csraxll/taller1-g8/README.md

# taller1-g8
Repositorio del proyecto del Grupo 8 para la materia Taller de Proyecto 1 - Ingeniería en Computación - UNLP
