csraxll/taller1-g8/Informe_Final_Presentación.pdf

# Taller de Proyecto I -Informe Final

Proyecto: Controlador de cartel LED Grupo: 8
Integrantes:
Jourdón, Julián (424/7)
Maicá, Juan Manuel (436/2) López Acuña, Axel (248/9)
Scorza, Facundo Ricardo (615/3)

# Presentación

- Objetivos del proyecto y esquema inicial.
- Requerimientos funcionales y no funcionales del sistema.
- Presupuesto.
- Puertos de la CIAA utilizados.
- Diseño del poncho y del cartel LED.
- Interfaz de usuario y máquina de estados.
- Tareas y módulos de software.
- Distribución del proyecto.
- Sistema final en funcionamiento.

# Objetivos del proyecto

- Nuestro proyecto consiste en desarrollar un controlador para un cartel LED que podría estar conformado por una o varias matrices de LEDs acopladas e interconectadas entre sí.
- El controlador contará con una lógica tal que podrá mostrar en el cartel cualquier tipo de mensaje y lo desplazará a través de las matrices.

# Esquema inicial

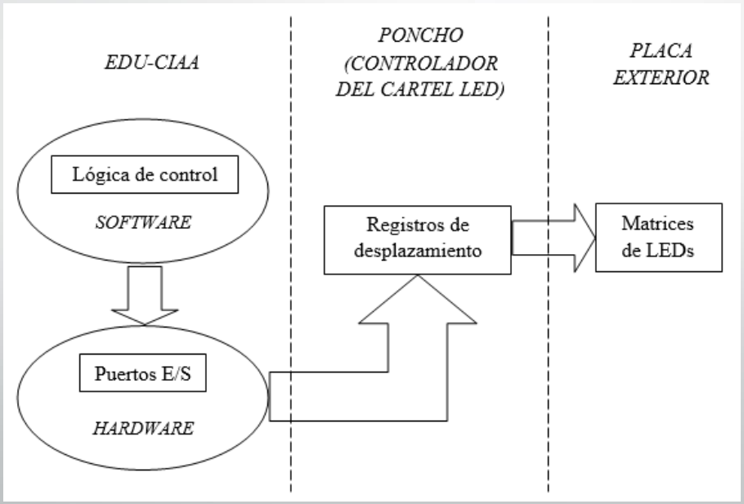
[picture p2: figure]

# Requerimientos funcionales del sistema

- Funciones principales del sistema:
- Ingresar mensaje.
- Realizar una operación aritmética.
- Llevar a cabo una conversión entre sistemas de numeración.
- Interacción del usuario con el cartel LED.

# Requerimientos no funcionales del sistema

- Interacción del usuario con el sistema.
- Dimensiones del cartel LED.
- Diseño del poncho.
- Dimensiones de las matrices de LEDs.
- Sistema operativo y lenguaje de programación.

# Presupuesto

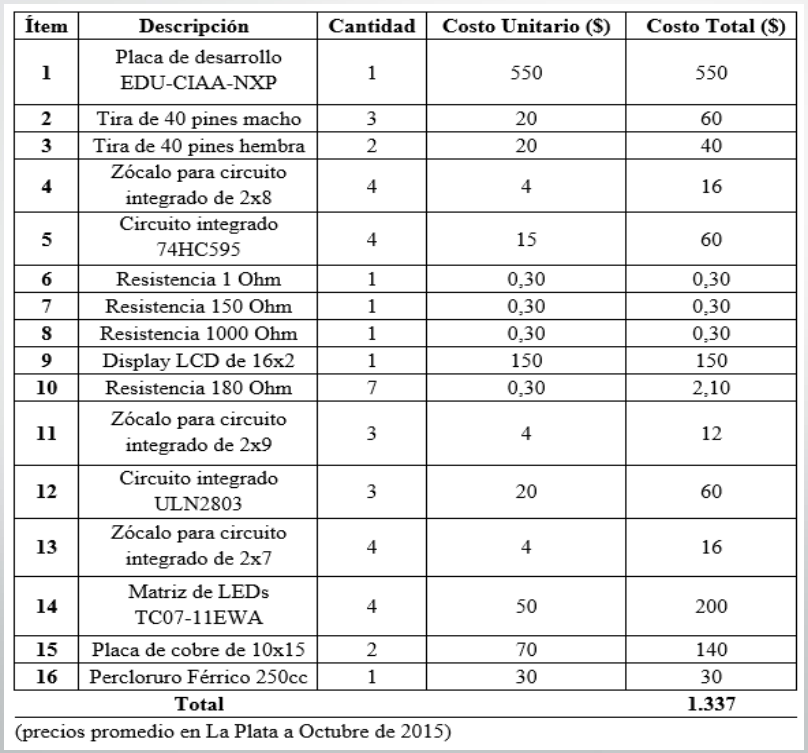
[picture p3: figure]

# Puertos de la CIAA utilizados

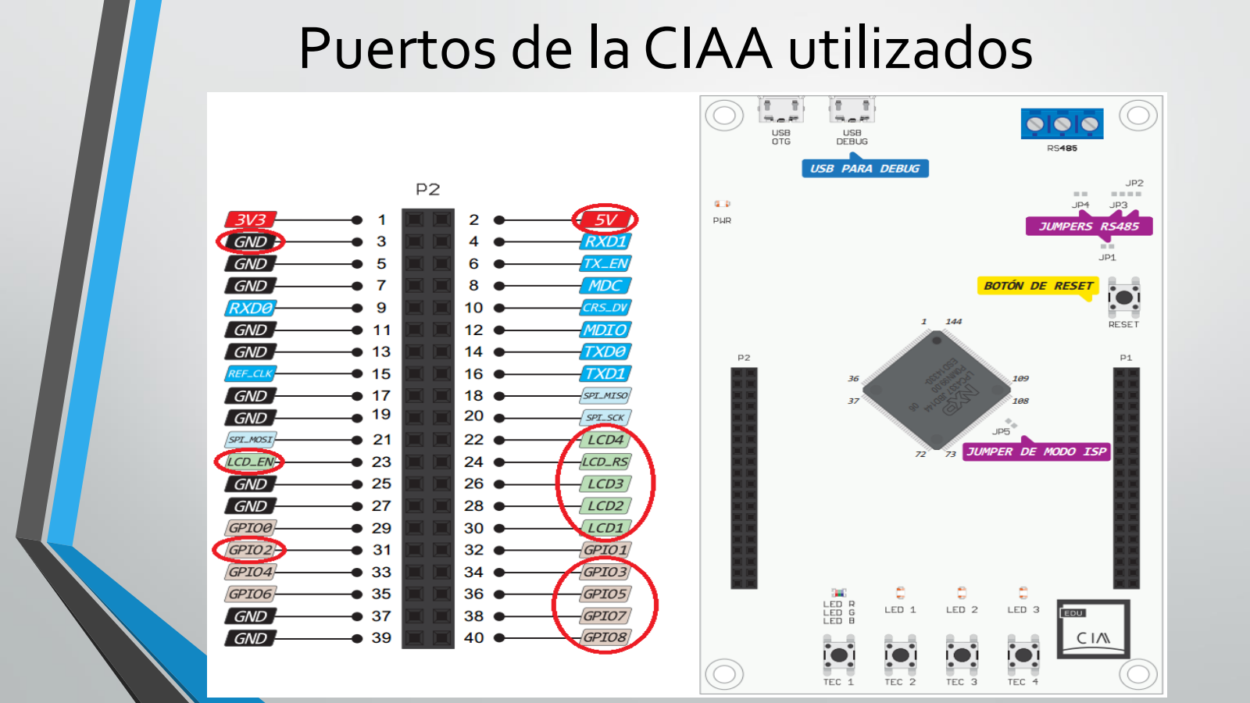
[picture p4: page 8]

# Diseño del poncho

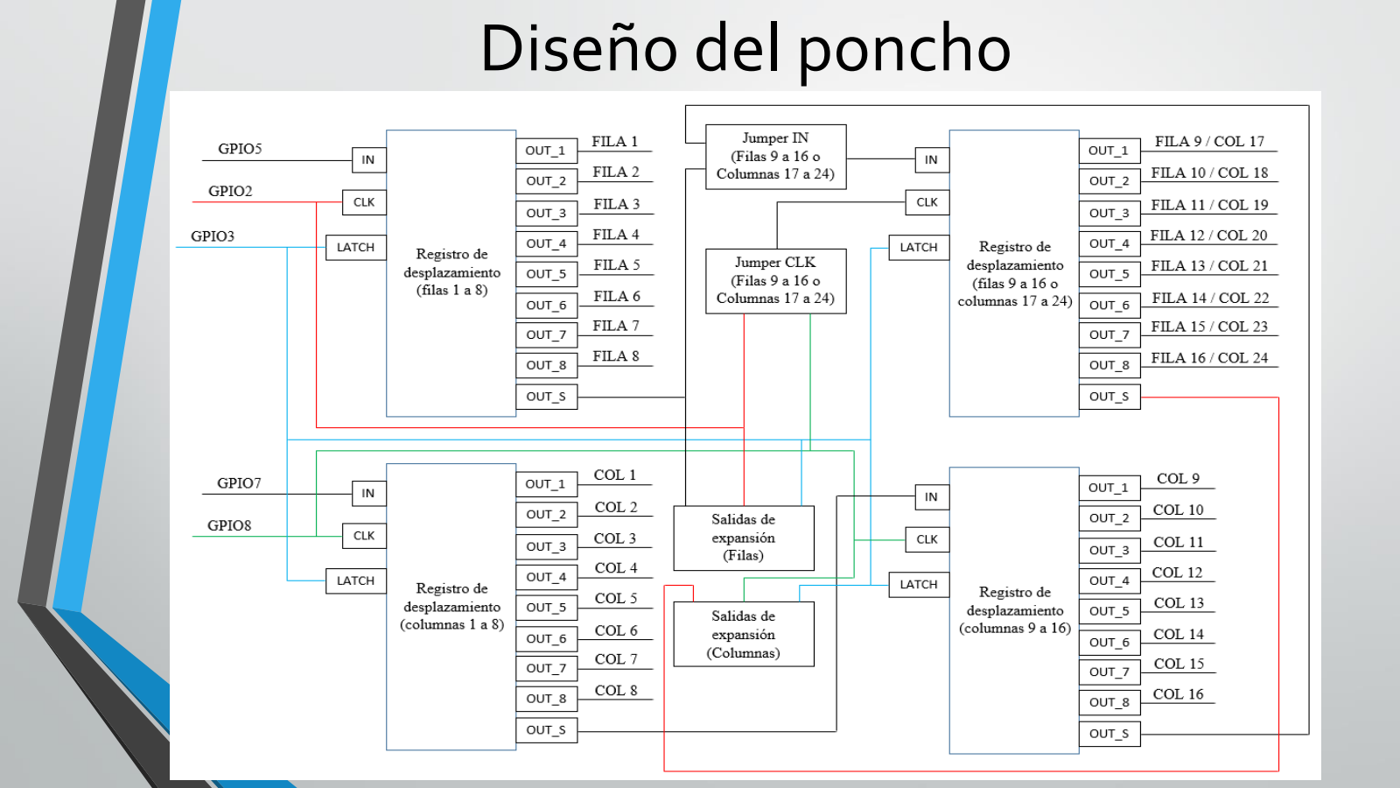
[picture p5: page 9]

# Diseño del poncho

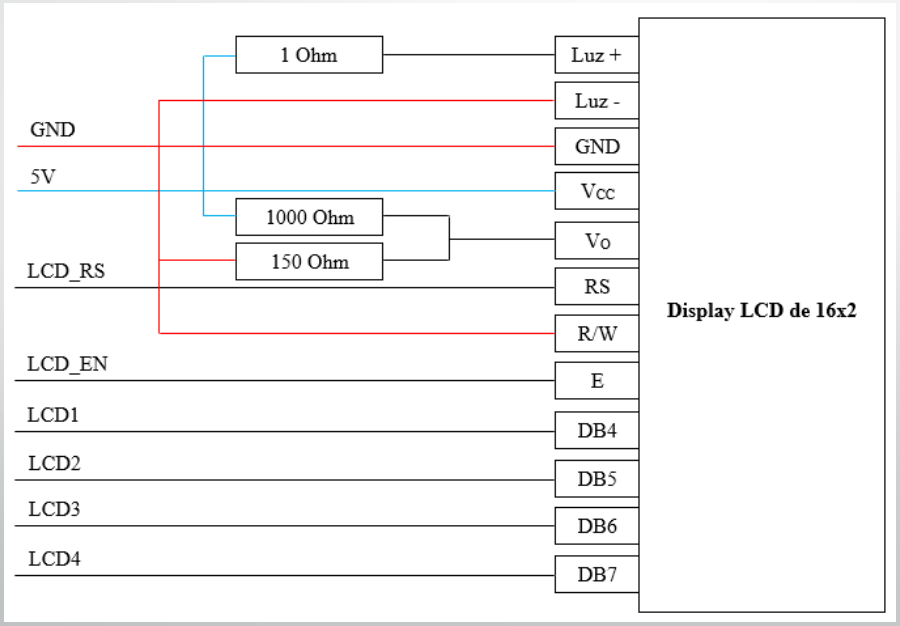
[picture p6: figure]

# Diseño del cartel LED

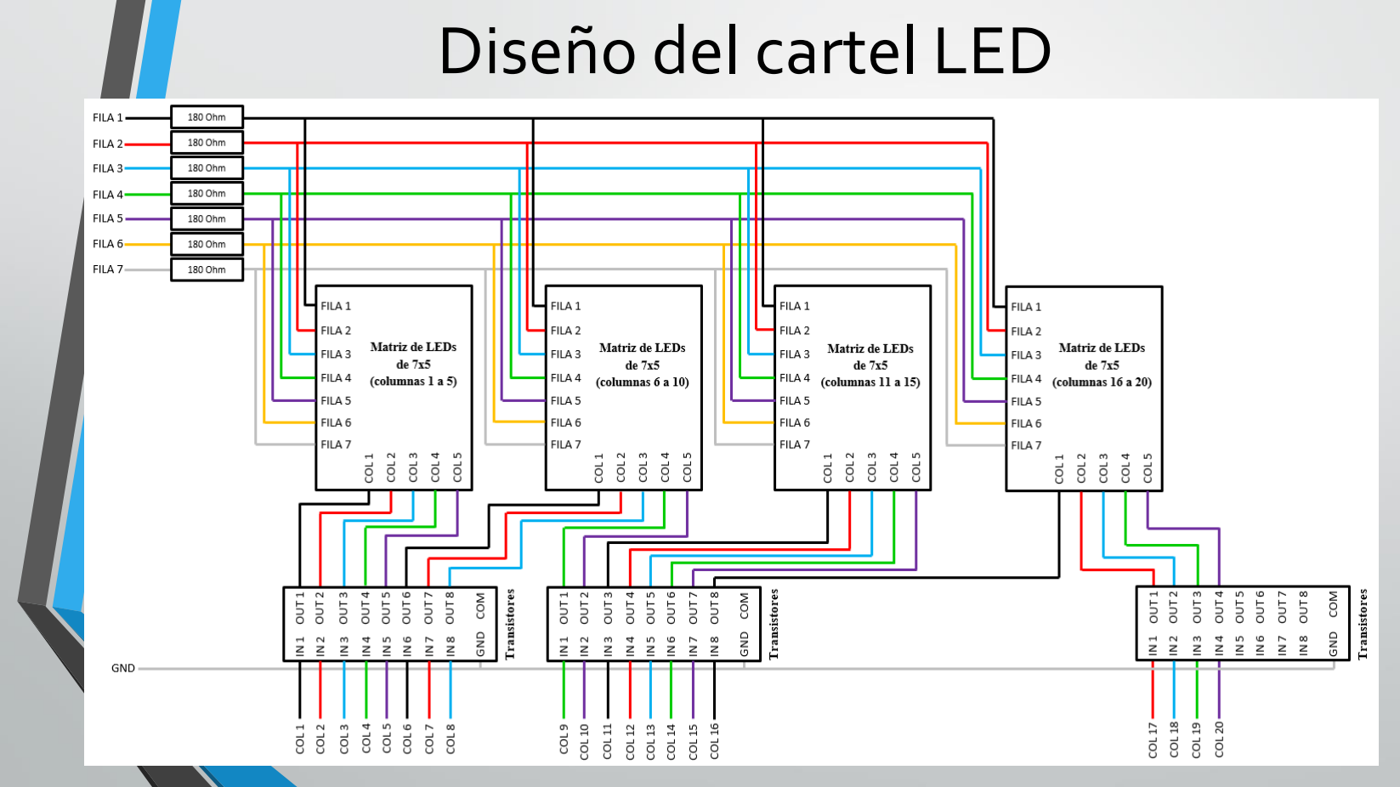
[picture p7: page 11]

# Interfaz de usuario

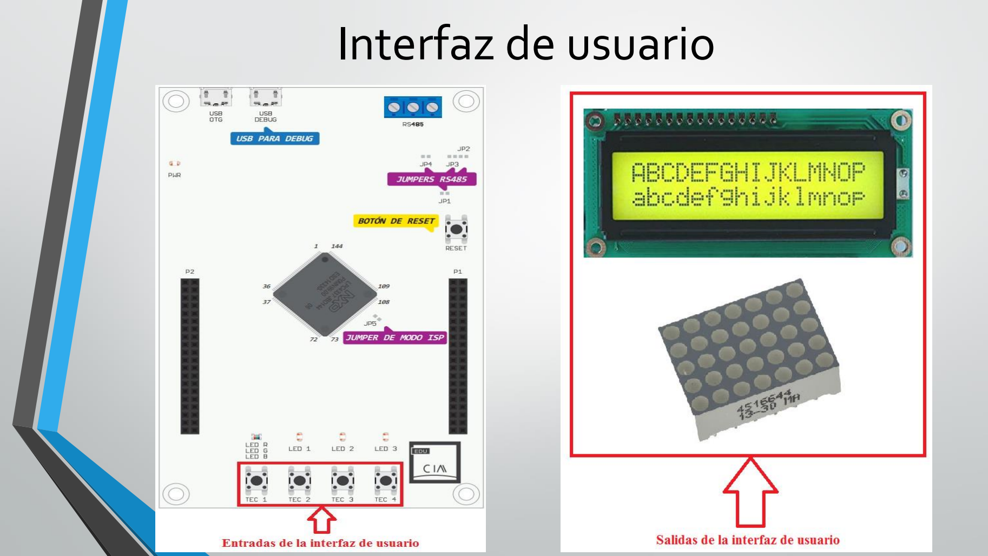
[picture p8: page 12]

# Máquina de estados

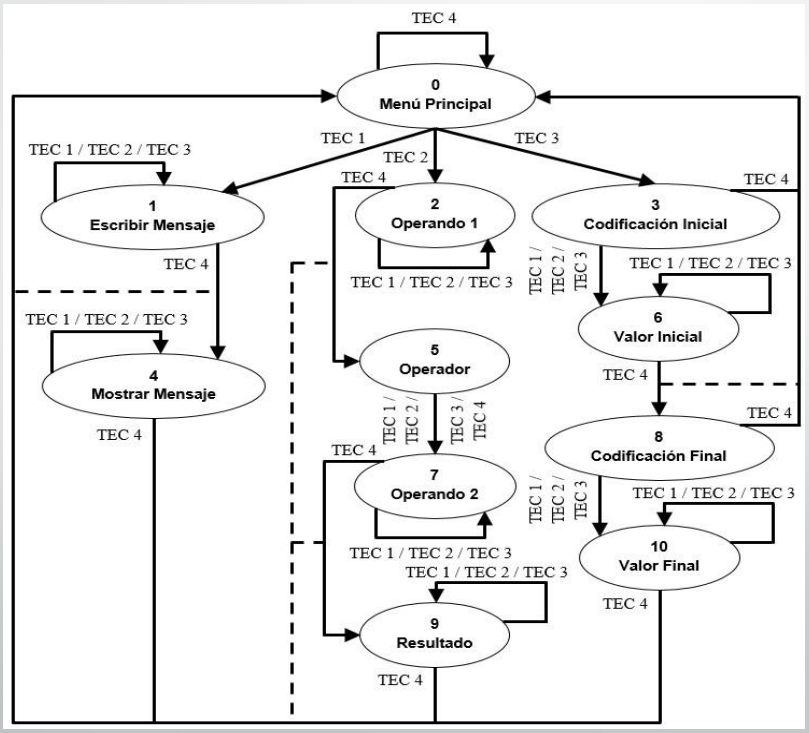
[picture p9: figure]

# Tareas

- InitTask → Se ejecuta una única vez al principio
- LcdTask → Período = 10 milisegundos
- MatrizTask → Período = 25 milisegundos
- RegistrosTask → Período = 1 milisegundo
- SwitchesTask → Período = 10 milisegundos

# Módulos de software

- Calculadora.
- Conversor.
- Interfaz.
- Lcd.
- Matriz.

# Módulos de software

- Proyecto.
- Puertos.
- Registros.
- Switches.
- Tiempo.

# Distribución del proyecto

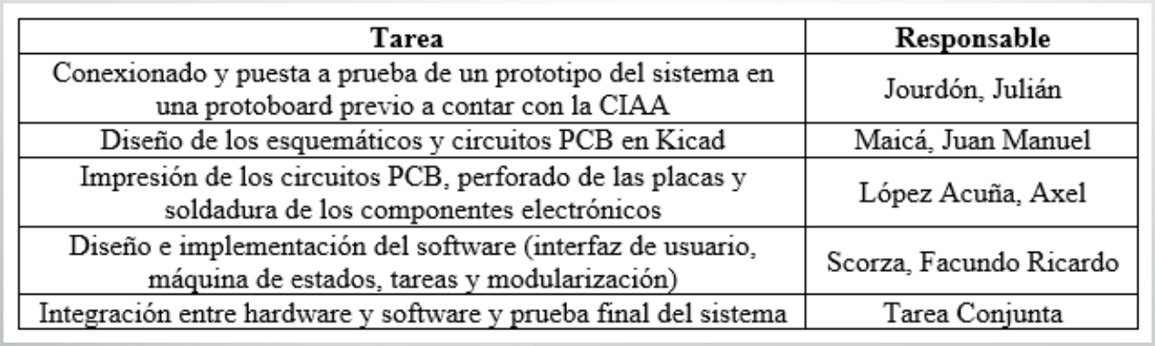
[picture p10: figure]

# Sistema final en funcionamiento

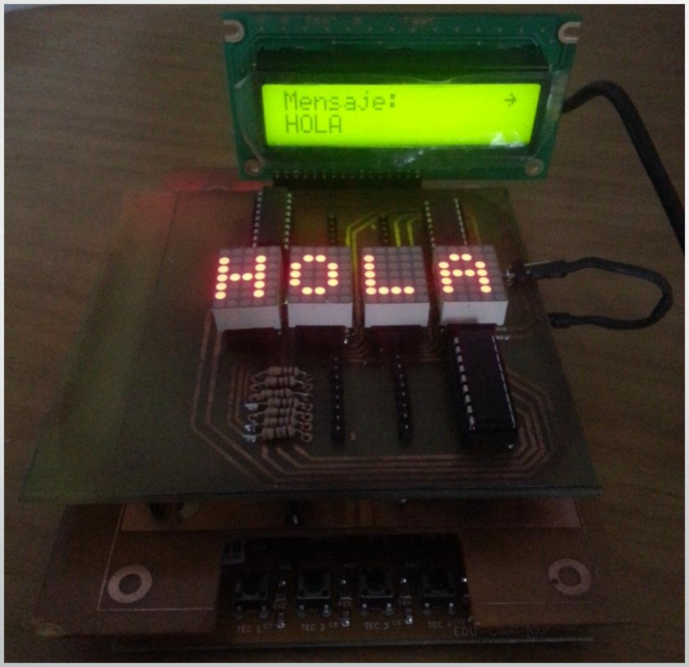
[picture p11: figure]

# ¿Preguntas?

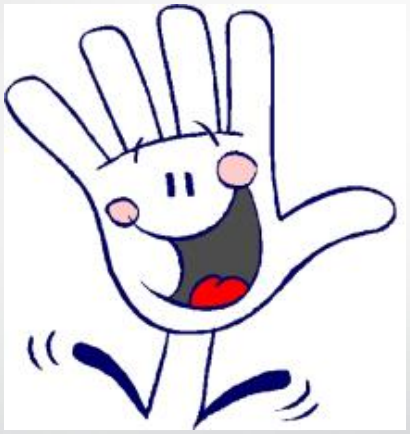
[picture p12: figure]

# ¡Muchas gracias!

Proyecto Github: www.github.com/csraxll/taller1-g8
