csraxll/taller1-g8/Hardware/PCB/MatrizLED/doc/CAMBIOS.txt

Historial de cambios realizados 
================================

* Fecha: 22/02/2016
* Autores: Juan Manuel Maicá, Lopez Acuña Axel
* Archivos:   - MatrizLED.sch
              - MatrizLED.kicad_pcb
              - MatrizLED.net
              - MatrizLED.pro
              - MatrizLED-cache.lib
* Descripción: Se parte de los Modelos de Ponchos en: 
               http://www.proyecto-ciaa.com.ar/devwiki/doku.php?id=desarrollo:edu-ciaa:ponchos_modelos
               <<Colocar aquí información de cambios importantes y de gran volumen, releases, contribuciones
                de terceros, etc.>>
