csraxll/taller1-g8/Hardware/PCB/MatrizLED/doc/Impreso - Dos Caras.pdf

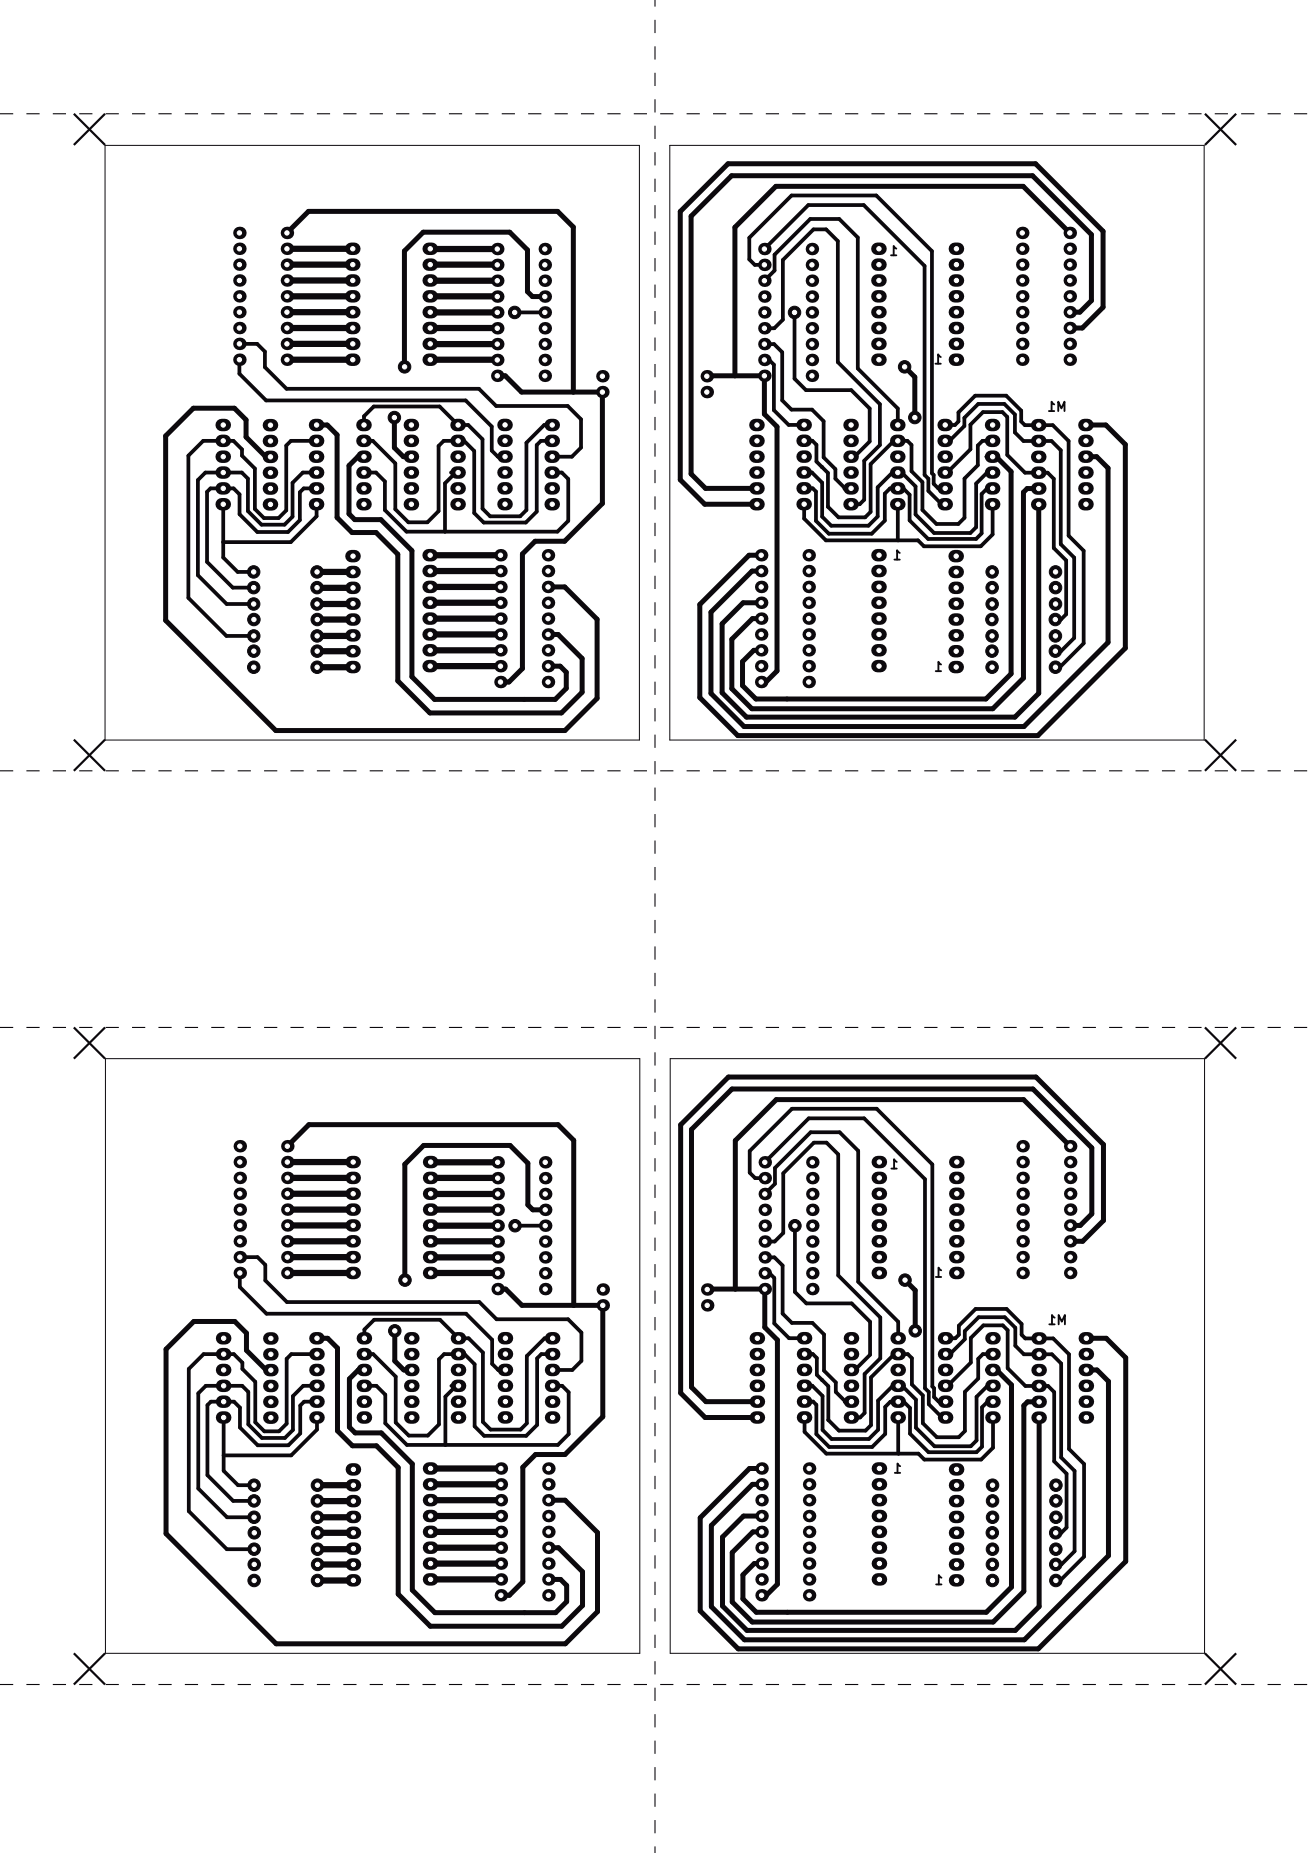
[picture p44: page 1]
