csraxll/taller1-g8/Hardware/PCB/ControladorMatrizLED/doc/Impreso - Back.pdf

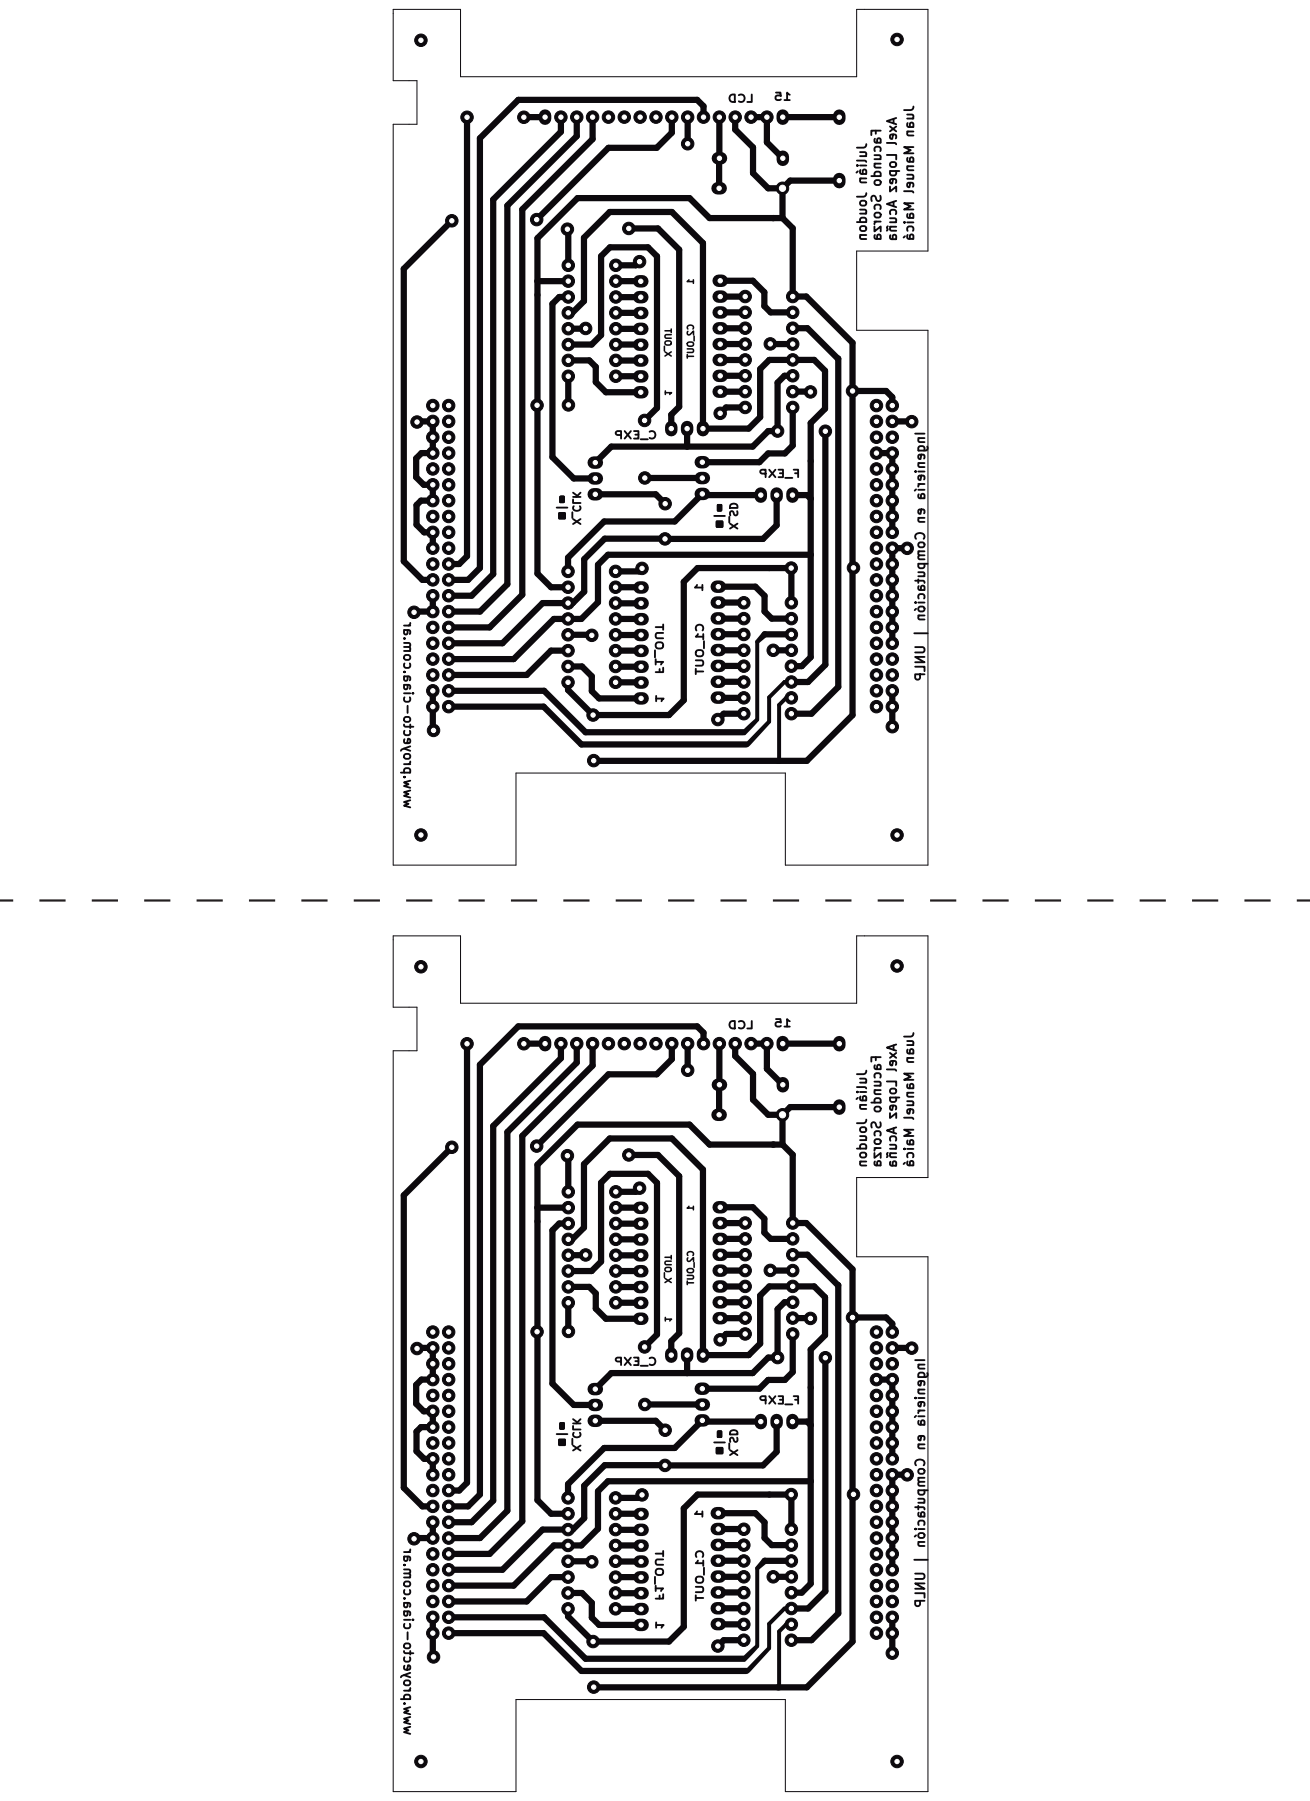
[picture p45: page 1]
