csraxll/taller1-g8/Hardware/PCB/MatrizLED/MatrizLED.kicad_pcb

## KiCad design Hardware/PCB/MatrizLED/MatrizLED.kicad_pcb (2016-01-29)

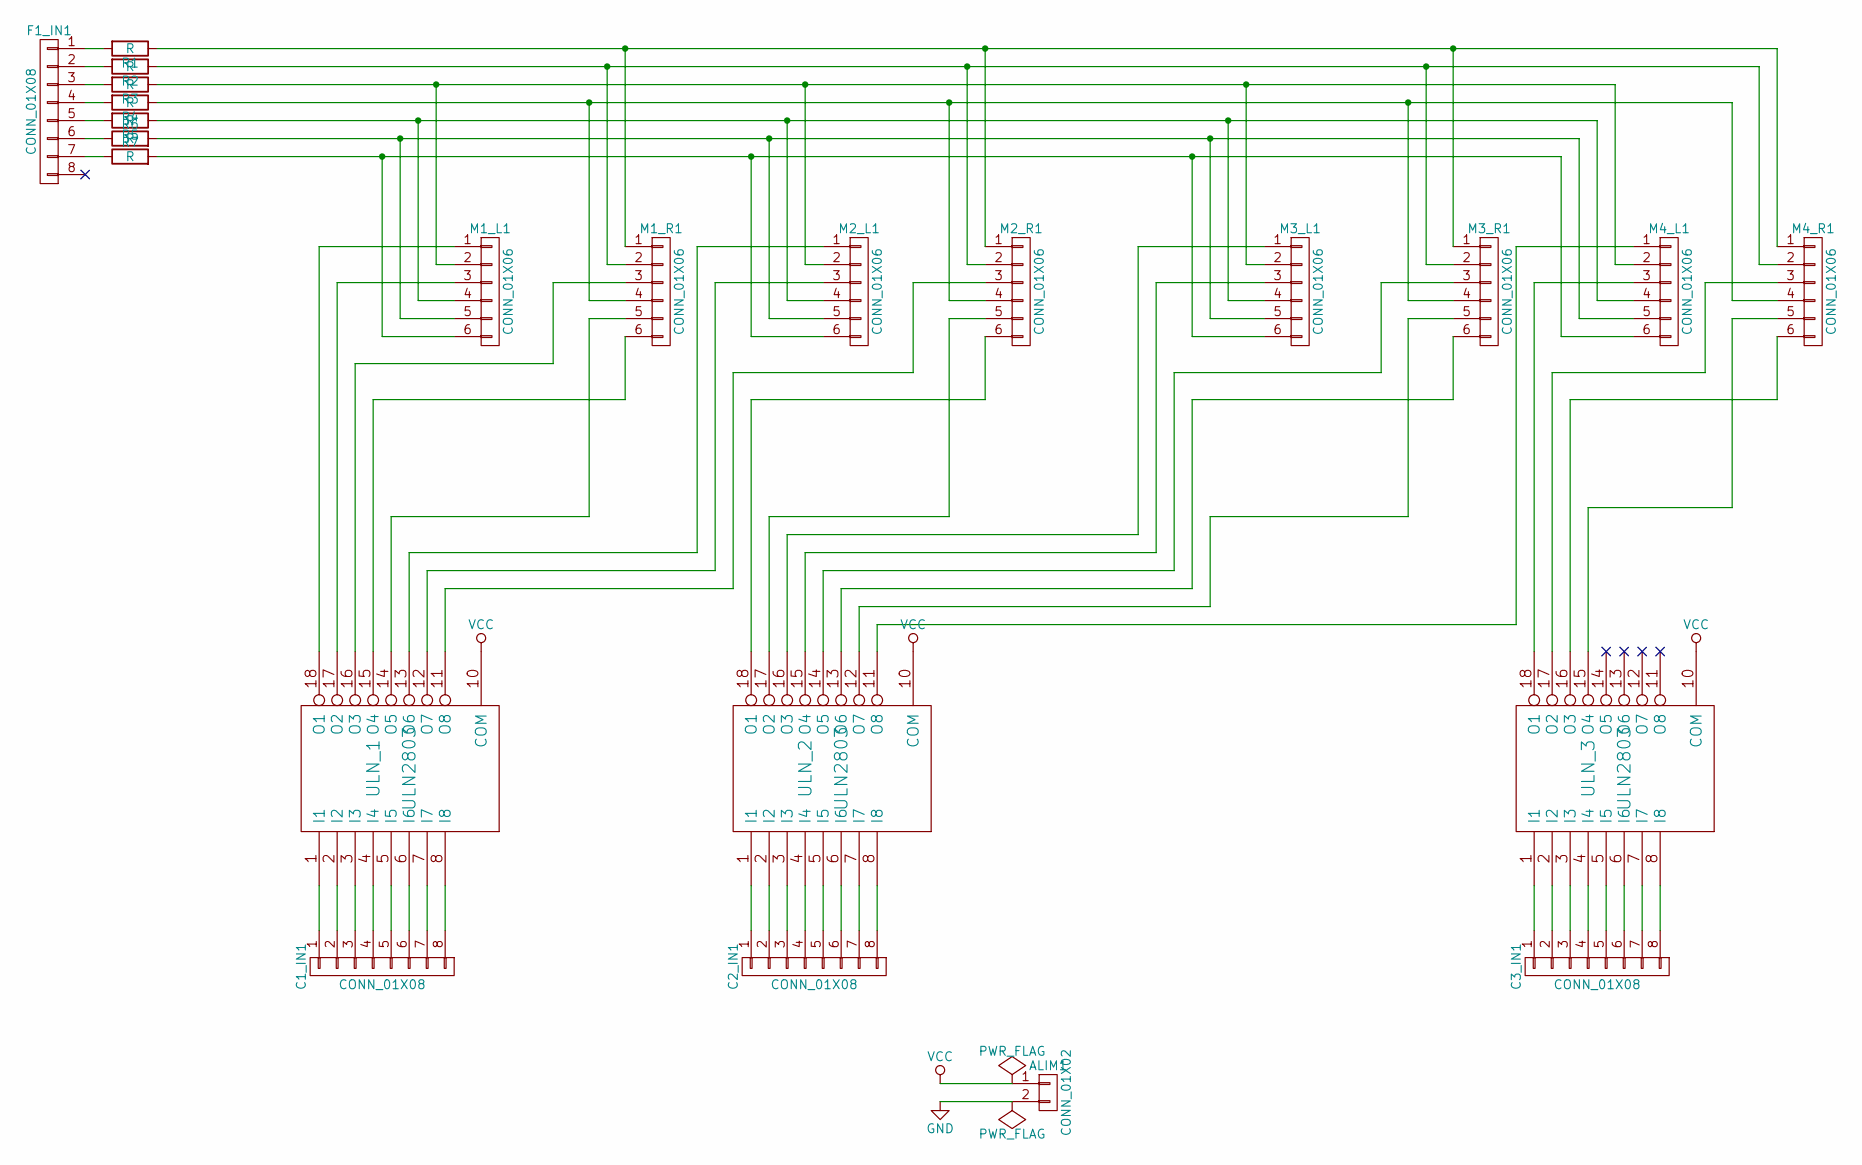
[picture p46: schematic MatrizLED.sch]

Parts:
ALIM1: CONN_01X02; Pin_Header_Straight_1x02
C1_IN1, C2_IN1, C3_IN1: CONN_01X08; Pin_Header_Straight_1x08
F1_IN1: CONN_01X08; Pin_Header_Straight_1x08
M1_L1, M1_R1, M2_L1, M2_R1, M3_L1, M3_R1, M4_L1, M4_R1: CONN_01X06; Pin_Header_Straight_1x06
R1, R2, R3, R4, R5, R6, R7: R; Resistor_Horizontal_RM10mm
ULN_1, ULN_2, ULN_3: ULN2803; DIP-18_W7.62mm

Connections:
GND: ALIM1.2, ULN_1.9 (GND), ULN_2.9 (GND), ULN_3.9 (GND)
unnamed: C1_IN1.1, ULN_1.1 (I1)
unnamed: C1_IN1.2, ULN_1.2 (I2)
unnamed: C1_IN1.3, ULN_1.3 (I3)
unnamed: C1_IN1.4, ULN_1.4 (I4)
unnamed: C1_IN1.5, ULN_1.5 (I5)
unnamed: C1_IN1.6, ULN_1.6 (I6)
unnamed: C1_IN1.7, ULN_1.7 (I7)
unnamed: C1_IN1.8, ULN_1.8 (I8)
unnamed: C2_IN1.1, ULN_2.1 (I1)
unnamed: C2_IN1.2, ULN_2.2 (I2)
unnamed: C2_IN1.3, ULN_2.3 (I3)
unnamed: C2_IN1.4, ULN_2.4 (I4)
unnamed: C2_IN1.5, ULN_2.5 (I5)
unnamed: C2_IN1.6, ULN_2.6 (I6)
unnamed: C2_IN1.7, ULN_2.7 (I7)
unnamed: C2_IN1.8, ULN_2.8 (I8)
unnamed: C3_IN1.1, ULN_3.1 (I1)
unnamed: C3_IN1.2, ULN_3.2 (I2)
unnamed: C3_IN1.3, ULN_3.3 (I3)
unnamed: C3_IN1.4, ULN_3.4 (I4)
unnamed: C3_IN1.5, ULN_3.5 (I5)
unnamed: C3_IN1.6, ULN_3.6 (I6)
unnamed: C3_IN1.7, ULN_3.7 (I7)
unnamed: C3_IN1.8, ULN_3.8 (I8)
unnamed: F1_IN1.1, R1.2
unnamed: F1_IN1.2, R2.2
unnamed: F1_IN1.3, R3.2
unnamed: F1_IN1.4, R4.2
unnamed: F1_IN1.5, R5.2
unnamed: F1_IN1.6, R6.1
unnamed: F1_IN1.7, R7.1
unnamed: M1_L1.1, ULN_1.18 (O1)
unnamed: M1_L1.2, M2_L1.2, M3_L1.2, M4_L1.2, R3.1
unnamed: M1_L1.3, ULN_1.17 (O2)
unnamed: M1_L1.4, M2_L1.4, M3_L1.4, M4_L1.4, R5.1
unnamed: M1_L1.5, M2_L1.5, M3_L1.5, M4_L1.5, R6.2
unnamed: M1_L1.6, M2_L1.6, M3_L1.6, M4_L1.6, R7.2
unnamed: M1_R1.1, M2_R1.1, M3_R1.1, M4_R1.1, R1.1
unnamed: M1_R1.2, M2_R1.2, M3_R1.2, M4_R1.2, R2.1
unnamed: M1_R1.3, ULN_1.16 (O3)
unnamed: M1_R1.4, M2_R1.4, M3_R1.4, M4_R1.4, R4.1
unnamed: M1_R1.5, ULN_1.14 (O5)
unnamed: M1_R1.6, ULN_1.15 (O4)
unnamed: M2_L1.1, ULN_1.13 (O6)
unnamed: M2_L1.3, ULN_1.12 (O7)
unnamed: M2_R1.3, ULN_1.11 (O8)
unnamed: M2_R1.5, ULN_2.17 (O2)
unnamed: M2_R1.6, ULN_2.18 (O1)
unnamed: M3_L1.1, ULN_2.16 (O3)
unnamed: M3_L1.3, ULN_2.15 (O4)
unnamed: M3_R1.3, ULN_2.14 (O5)
unnamed: M3_R1.5, ULN_2.12 (O7)
unnamed: M3_R1.6, ULN_2.13 (O6)
unnamed: M4_L1.1, ULN_2.11 (O8)
unnamed: M4_L1.3, ULN_3.18 (O1)
unnamed: M4_R1.3, ULN_3.17 (O2)
unnamed: M4_R1.5, ULN_3.15 (O4)
unnamed: M4_R1.6, ULN_3.16 (O3)
VCC: ALIM1.1, ULN_1.10 (COM), ULN_2.10 (COM), ULN_3.10 (COM)

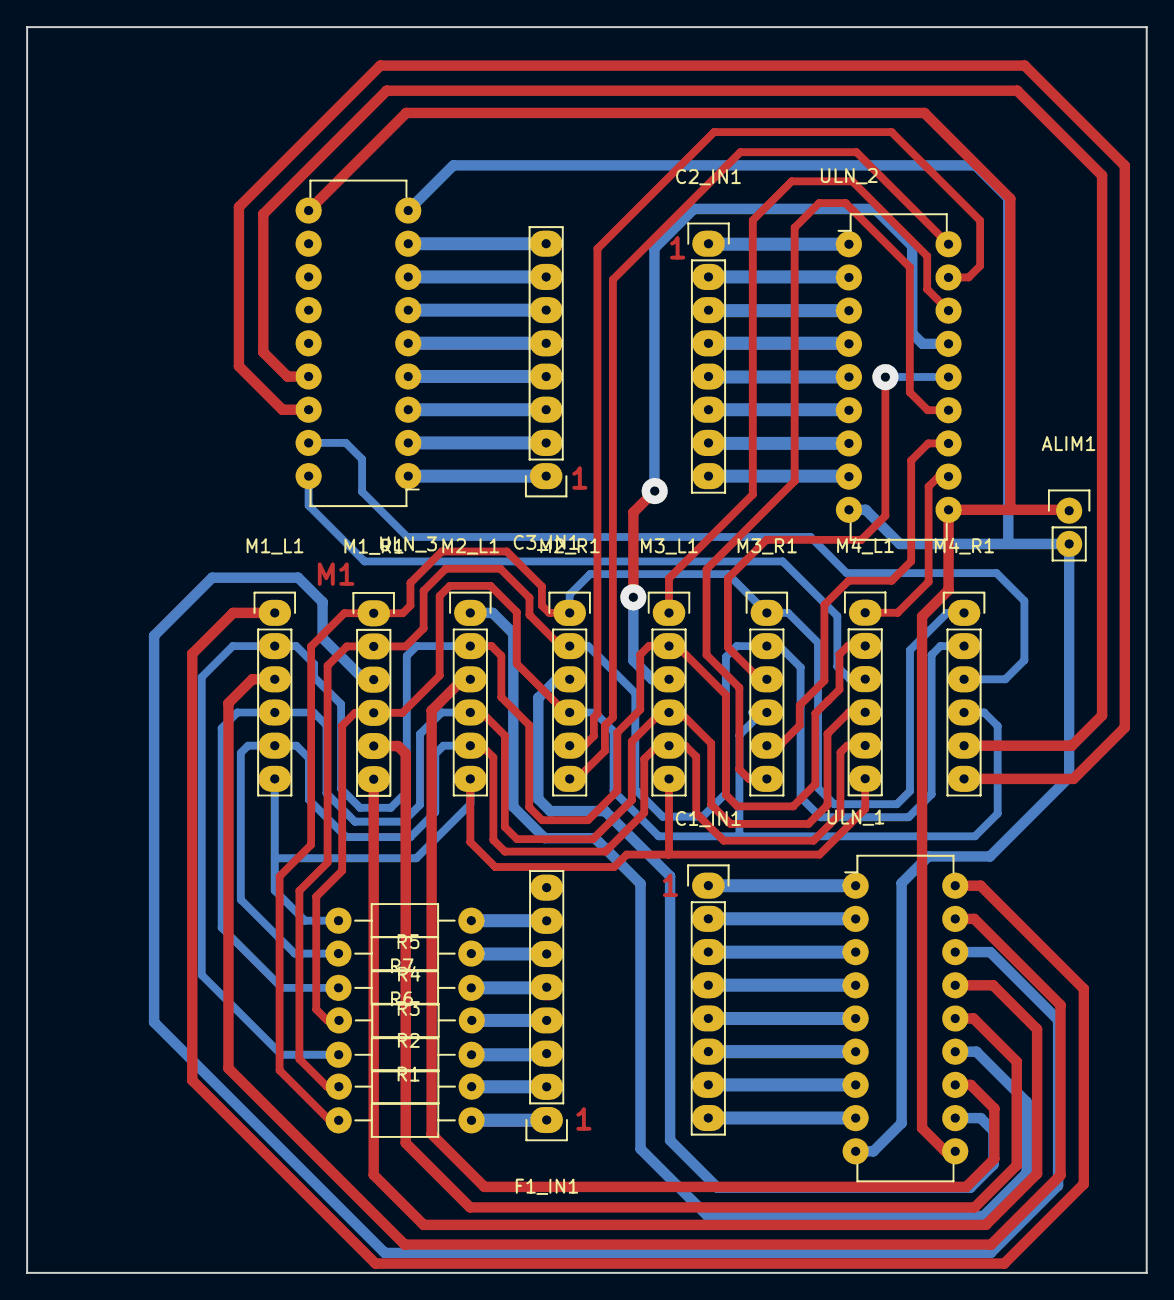
[picture p47: board MatrizLED.kicad_pcb from above]

Board: 2 copper layers, 85.7 x 95.3 mm, 23 parts (0 on the bottom side), 60 nets.
