csraxll/taller1-g8/Hardware/PCB/ControladorMatrizLED/ControladorMatrizLED.kicad_pcb

## KiCad design Hardware/PCB/ControladorMatrizLED/ControladorMatrizLED.kicad_pcb (2015-12-13)

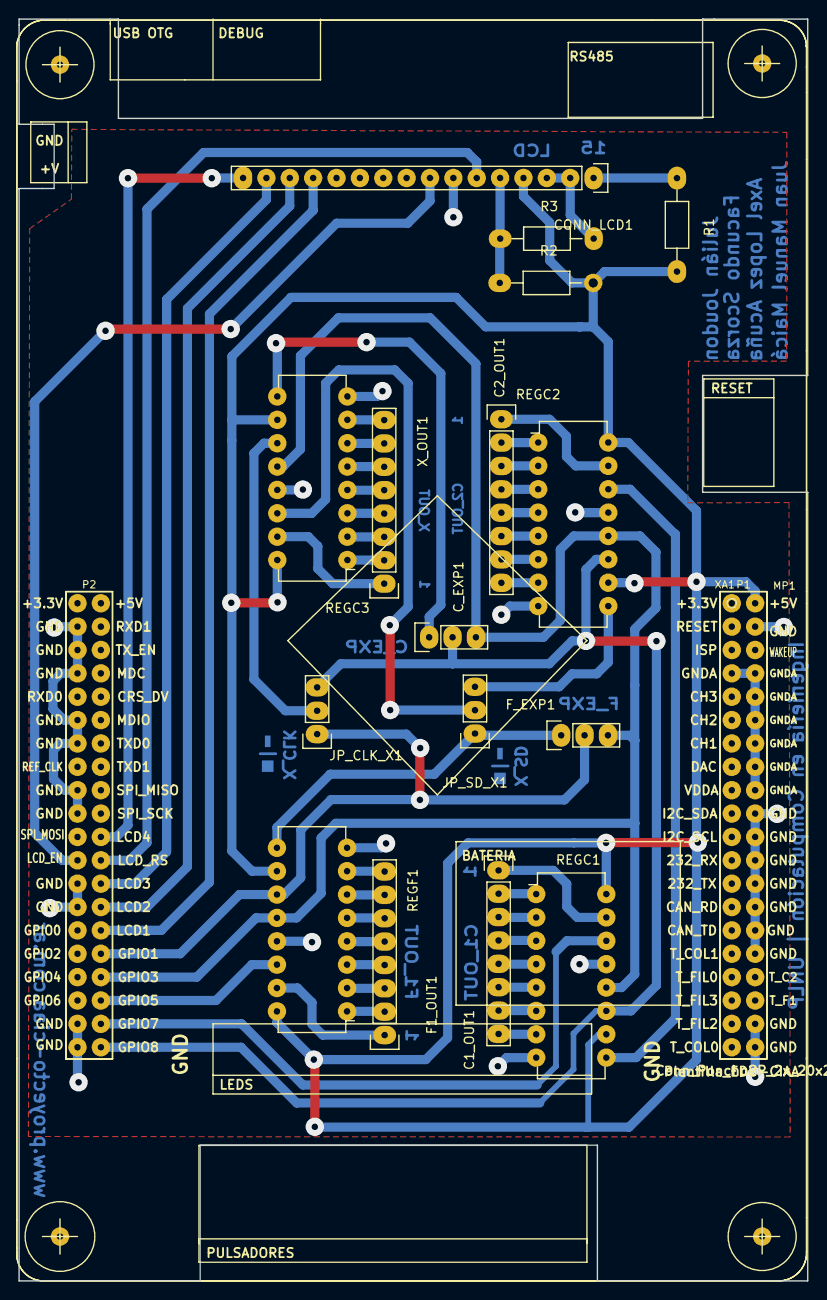
[picture p48: board ControladorMatrizLED.kicad_pcb from above]

Board: 2 copper layers, 85.7 x 137.2 mm, 18 parts (0 on the bottom side), 54 nets.

Parts:
C1_OUT1, C2_OUT1: CONN_01X08; Socket_Strip_Straight_1x08
CONN_LCD1: CONN_01X16; Socket_Strip_Straight_1x16
C_EXP1: CONN_01X03; Socket_Strip_Straight_1x03
F1_OUT1: CONN_01X08; Socket_Strip_Straight_1x08
F_EXP1: CONN_01X03; Socket_Strip_Straight_1x03
JP_CLK_X1: CONN_01X03; Socket_Strip_Straight_1x03
JP_SD_X1: CONN_01X03; Socket_Strip_Straight_1x03
MP1: Plantilla_EDU-CIAA
R1, R2, R3: R; Resistor_Horizontal_RM10mm
REGC1, REGC2, REGC3: 74HC595; DIP-16_W7.62mm
REGF1: 74HC595; DIP-16_W7.62mm
XA1: Conn_Poncho2P_2x_20x2; poncho_grande
X_OUT1: CONN_01X08; Socket_Strip_Straight_1x08

Connections:
/Circuito Principal/GPIO1: F_EXP1.2, JP_CLK_X1.1, REGF1.11, XA1.72
/Circuito Principal/GPIO3: C_EXP1.3, F_EXP1.3, REGC1.12, REGC2.12, REGC3.12, REGF1.12, XA1.74
/Circuito Principal/GPIO5: REGF1.14, XA1.76
/Circuito Principal/GPIO7: REGC1.14, XA1.78
/Circuito Principal/GPIO8: C_EXP1.2, JP_CLK_X1.3, REGC1.11, REGC2.11, XA1.80
/Circuito Principal/LCD1: CONN_LCD1.13, XA1.70
/Circuito Principal/LCD2: CONN_LCD1.14, XA1.68
/Circuito Principal/LCD3: CONN_LCD1.15, XA1.66
/Circuito Principal/LCD4: CONN_LCD1.16, XA1.62
/Circuito Principal/LCD_EN: CONN_LCD1.8, XA1.63
/Circuito Principal/RS: CONN_LCD1.6, XA1.64
GND: CONN_LCD1.2, CONN_LCD1.3, CONN_LCD1.7, R3.2, REGC1.8, REGC1.13, REGC2.8, REGC2.13, REGC3.8, REGC3.13, REGF1.8, REGF1.13, XA1.4, XA1.20, XA1.22, XA1.24, XA1.26, XA1.28, XA1.30, XA1.32, XA1.38, XA1.40, XA1.43, XA1.45, XA1.47, XA1.51, XA1.53, XA1.57, XA1.59, XA1.65, XA1.67, XA1.77, XA1.79
GNDA: XA1.7, XA1.8, XA1.10, XA1.12, XA1.14, XA1.16, XA1.18
unnamed: C1_OUT1.1, REGC1.15
unnamed: C1_OUT1.2, REGC1.1
unnamed: C1_OUT1.3, REGC1.2
unnamed: C1_OUT1.4, REGC1.3
unnamed: C1_OUT1.5, REGC1.4
unnamed: C1_OUT1.6, REGC1.5
unnamed: C1_OUT1.7, REGC1.6
unnamed: C1_OUT1.8, REGC1.7
unnamed: C2_OUT1.1, REGC2.15
unnamed: C2_OUT1.2, REGC2.1
unnamed: C2_OUT1.3, REGC2.2
unnamed: C2_OUT1.4, REGC2.3
unnamed: C2_OUT1.5, REGC2.4
unnamed: C2_OUT1.6, REGC2.5
unnamed: C2_OUT1.7, REGC2.6
unnamed: C2_OUT1.8, REGC2.7
unnamed: CONN_LCD1.1, R1.1
unnamed: CONN_LCD1.5, R2.1, R3.1
unnamed: C_EXP1.1, REGC3.9
unnamed: F1_OUT1.1, REGF1.15
unnamed: F1_OUT1.2, REGF1.1
unnamed: F1_OUT1.3, REGF1.2
unnamed: F1_OUT1.4, REGF1.3
unnamed: F1_OUT1.5, REGF1.4
unnamed: F1_OUT1.6, REGF1.5
unnamed: F1_OUT1.7, REGF1.6
unnamed: F1_OUT1.8, REGF1.7
unnamed: F_EXP1.1, JP_SD_X1.1, REGF1.9
unnamed: JP_CLK_X1.2, REGC3.11
unnamed: JP_SD_X1.2, REGC3.14
unnamed: JP_SD_X1.3, REGC2.9
unnamed: REGC1.9, REGC2.14
unnamed: REGC3.1, X_OUT1.2
unnamed: REGC3.2, X_OUT1.3
unnamed: REGC3.3, X_OUT1.4
unnamed: REGC3.4, X_OUT1.5
unnamed: REGC3.5, X_OUT1.6
unnamed: REGC3.6, X_OUT1.7
unnamed: REGC3.7, X_OUT1.8
unnamed: REGC3.15, X_OUT1.1
VCC: CONN_LCD1.4, R1.2, R2.2, REGC1.10, REGC1.16, REGC2.10, REGC2.16, REGC3.10, REGC3.16, REGF1.10, REGF1.16, XA1.2
