csraxll/taller1-g8/Software/Firmware/proyecto/src/proyecto.c

/* Copyright 2014, Mariano Cerdeiro
 * Copyright 2014, Pablo Ridolfi
 * Copyright 2014, Juan Cecconi
 * Copyright 2014, Gustavo Muro
 *
 * This file is part of CIAA Firmware.
 *
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
 * 3. Neither the name of the copyright holder nor the names of its
 *    contributors may be used to endorse or promote products derived from this
 *    software without specific prior written permission.
 *
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
 */

/** \brief Blinking_echo example source file
 **
 ** This is a mini example of the CIAA Firmware.
 **
 **/

/** \addtogroup CIAA_Firmware CIAA Firmware
 ** @{ */
/** \addtogroup Examples CIAA Firmware Examples
 ** @{ */
/** \addtogroup Blinking Blinking_echo example source file
 ** @{ */

/*
 * Initials     Name
 * ---------------------------
 * MaCe         Mariano Cerdeiro
 * PR           Pablo Ridolfi
 * JuCe         Juan Cecconi
 * GMuro        Gustavo Muro
 * ErPe         Eric Pernia
 */

/*
 * modification history (new versions first)
 * -----------------------------------------------------------
 * 20150603 v0.0.3   ErPe change uint8 type by uint8_t
 *                        in line 172
 * 20141019 v0.0.2   JuCe add printf in each task,
 *                        remove trailing spaces
 * 20140731 v0.0.1   PR   first functional version
 */

/*==================[inclusions]=============================================*/
#include "os.h"               /* <= operating system header */
#include "ciaaPOSIX_stdio.h"  /* <= device handler header */
#include "ciaaPOSIX_string.h" /* <= string header */
#include "ciaak.h"            /* <= ciaa kernel header */
#include "proyecto.h"         /* <= own header */
#include "lcd.h"			  /* <= controlador de display LCD */
#include "matriz.h"			  /* <= controlador de matriz */
#include "interfaz.h"		  /* <= interfaz con el usuario */
#include "puertos.h"			  /* <= driver puertos GPIO y LCD */
#include "switches.h"		  /* <= estado de los switches */
#include "registros.h"		  /* <= control de los registros de desplazamiento */

/*==================[macros and definitions]=================================*/
#define PERIODO_LCD 10
#define PERIODO_MATRIZ 25
#define PERIODO_REGISTROS 1
#define PERIODO_SWITCHES 10
#define INICIO 50

/*==================[internal data declaration]==============================*/

/*==================[internal functions declaration]=========================*/

/*==================[internal data definition]===============================*/

/*==================[external data definition]===============================*/

/*==================[internal functions definition]==========================*/

/*==================[external functions definition]==========================*/
/** \brief Main function
 *
 * This is the main entry point of the software.
 *
 * \returns 0
 *
 * \remarks This function never returns. Return value is only to avoid compiler
 *          warnings or errors.
 */
int main(void)
{
   /* Starts the operating system in the Application Mode 1 */
   /* This example has only one Application Mode */
   StartOS(AppMode1);

   /* StartOs shall never returns, but to avoid compiler warnings or errors
    * 0 is returned */
   return 0;
}

/** \brief Error Hook function
 *
 * This fucntion is called from the os if an os interface (API) returns an
 * error. Is for debugging proposes. If called this function triggers a
 * ShutdownOs which ends in a while(1).
 *
 * The values:
 *    OSErrorGetServiceId
 *    OSErrorGetParam1
 *    OSErrorGetParam2
 *    OSErrorGetParam3
 *    OSErrorGetRet
 *
 * will provide you the interface, the input parameters and the returned value.
 * For more details see the OSEK specification:
 * http://portal.osek-vdx.org/files/pdf/specs/os223.pdf
 *
 */
void ErrorHook(void)
{
   ciaaPOSIX_printf("ErrorHook was called\n");
   ciaaPOSIX_printf("Service: %d, P1: %d, P2: %d, P3: %d, RET: %d\n", OSErrorGetServiceId(), OSErrorGetParam1(), OSErrorGetParam2(), OSErrorGetParam3(), OSErrorGetRet());
   ShutdownOS(0);
}

/** \brief Initial task
 *
 * This task is started automatically in the application mode 1.
 */
TASK(InitTask)
{
   /* init CIAA kernel and devices */
   ciaak_start();

   /* open CIAA ports GPIO and LCD */
   Puertos_Inicializar();

   /* inicializar matriz de leds */
   Matriz_Inicializar();

   /* open CIAA inputs (switches) */
   Switches_Inicializar();

   /* inicializar interfaz con el usuario */
   Interfaz_Inicializar();

   /* activate periodic task */
   SetRelAlarm (ActivateLcdTask, INICIO, PERIODO_LCD);
   SetRelAlarm (ActivateMatrizTask, INICIO, PERIODO_MATRIZ);
   SetRelAlarm (ActivateRegistrosTask, INICIO, PERIODO_REGISTROS);
   SetRelAlarm (ActivateSwitchesTask, INICIO, PERIODO_SWITCHES);
   /* terminate task */
   TerminateTask();
}

/* brief Periodic Task */

TASK(LcdTask)
{
	Interfaz_CambiarSubmenu();
	Interfaz_Revisar();
	LCD_update();
	Interfaz_PosicionarLCD();
	TerminateTask();
}

TASK(MatrizTask)
{

   /* escribir mensaje en los registros */
   Matriz_DesplazarMensaje();

   /* terminate task */
   TerminateTask();
}

TASK(RegistrosTask)
{

	Registros_ActivarColumna();

	/* terminate task */
	TerminateTask();
}

TASK(SwitchesTask)
{
	Switches_Polling();
	TerminateTask();
}


/** @} doxygen end group definition */
/** @} doxygen end group definition */
/** @} doxygen end group definition */
/*==================[end of file]============================================*/
