csraxll/taller1-g8/Software/Firmware/proyecto/inc/Os_Cfg.h

/********************************************************
 * DO NOT CHANGE THIS FILE, IT IS GENERATED AUTOMATICALY*
 ********************************************************/

/* Copyright 2008, 2009, 2015 Mariano Cerdeiro
 * Copyright 2014, ACSE & CADIEEL
 *      ACSE: http://www.sase.com.ar/asociacion-civil-sistemas-embebidos/ciaa/
 *      CADIEEL: http://www.cadieel.org.ar
 *
 * This file is part of CIAA Firmware.
 *
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
 * 3. Neither the name of the copyright holder nor the names of its
 *    contributors may be used to endorse or promote products derived from this
 *    software without specific prior written permission.
 *
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
 */


#ifndef _OS_CFG_H_
#define _OS_CFG_H_
/** \brief FreeOSEK Os Generated Configuration Header File
 **
 ** This file contents the generated configuration of FreeOSEK Os
 **
 ** \file Os_Cfg.h
 **
 **/

/** \addtogroup FreeOSEK
 ** @{ */
/** \addtogroup FreeOSEK_Os
 ** @{ */
/** \addtogroup FreeOSEK_Os_Global
 ** @{ */

/*
 * Initials     Name
 * ---------------------------
 * MaCe         Mariano Cerdeiro
 */

/*
 * modification history (new versions first)
 * -----------------------------------------------------------
 * 20150619 v0.1.4 MaCe fix issue #279
 * 20090719 v0.1.3 MaCe rename file to Os_
 * 20090424 v0.1.2 MaCe add counters defines
 * 20090128 v0.1.1 MaCe add MEMMAP off configuration
 * 20080810 v0.1.0 MaCe initial version
 */

/*==================[inclusions]=============================================*/

/*==================[macros]=================================================*/
/** \brief Definition of the  DeclareTask Macro */
#define DeclareTask(name) void OSEK_TASK_ ## name (void)

#define OSEK_OS_INTERRUPT_MASK ((InterruptFlagsType)0xFFFFFFFFU)

/** \brief Task Definition */
#define InitTask 0
/** \brief Task Definition */
#define LcdTask 1
#define MatrizTask 2
#define RegistrosTask 3
#define SwitchesTask 4

/** \brief Definition of the Application Mode AppMode1 */
#define AppMode1 0

/** \brief Definition of the Event POSIXE */
#define POSIXE 0x1U

/** \brief Definition of the resource POSIXR */
#define POSIXR ((ResourceType)0)

/** \brief Definition of the Alarm ActivatePeriodicTask */
#define ActivateLcdTask 0
#define ActivateMatrizTask 1
#define ActivateRegistrosTask 2
#define ActivateSwitchesTask 3

/** \brief Definition of the Counter HardwareCounter */
#define HardwareCounter 0

/** \brief OS Error Get Service Id */
/* \req OSEK_ERR_0.1 The macro OSErrorGetServiceId() shall provide the service
 * identifier with a OSServiceIdType type where the error has been risen
 * \req OSEK_ERR_0.1.1 Possibly return values are: OSServiceId_xxxx, where
 * xxxx is the name of the system service
 */
#define OSErrorGetServiceId() (Osek_ErrorApi)

#define OSErrorGetParam1() (Osek_ErrorParam1)

#define OSErrorGetParam2() (Osek_ErrorParam2)

#define OSErrorGetParam3() (Osek_ErrorParam3)

#define OSErrorGetRet() (Osek_ErrorRet)

/** \brief OSEK_MEMMAP macro (OSEK_DISABLE not MemMap is used for FreeOSEK, OSEK_ENABLE
 ** MemMap is used for FreeOSEK) */
#define OSEK_MEMMAP OSEK_DISABLE
/** \brief Schedule this Task if higher priority Task are Active
 **
 ** \remarks if the system is configured with extended errors the
 **          function Schedule is implemented as a macro and calls the
 **          internal function Schedule_Int. If Standard errores are
 **          configured the function Schedule is implemented as a function.
 **
 ** This API shall Schedule the calling Task if a higher priority Task
 ** is active. This API shall only be used from non preemtive tasks.
 **
 ** \return E_OK if no error
 ** \return E_OS_CALLEVEL if call at interrupt level
 ** \return E_OS_RESOURCE if the calling task occupies resources
 **/
#define Schedule() Schedule_Int(TRUE)

/*==================[typedef]================================================*/
/** \brief Type definition of StatusType
 **
 ** This type is used to represent the status returned by all FreeOSEK APIs
 **/
/* \req OSEK_SYS_1.1 */
typedef unsigned char StatusType;


/*==================[external data declaration]==============================*/
/** \brief Error Api Variable
 **
 ** This variable contents the api which generate the last error
 **/
extern unsigned int Osek_ErrorApi;

/** \brief Error Param1 Variable
 **
 ** This variable contents the first parameter passed to the api which has
 ** generted the last error.
 **/
extern unsigned int Osek_ErrorParam1;

/** \brief Error Param2 Variable
 **
 ** This variable contents the second parameter passed to the api which has
 ** generted the last error.
 **/
extern unsigned int Osek_ErrorParam2;

/** \brief Error Param3 Variable
 **
 ** This variable contents the third parameter passed to the api which has
 ** generted the last error.
 **/
extern unsigned int Osek_ErrorParam3;

/** \brief Error Return Variable
 **
 ** This variable contents return value of the api which has generated
 ** the last error.
 **/
extern unsigned int Osek_ErrorRet;


/*==================[external functions declaration]=========================*/
/** \brief Error Hook */
extern void ErrorHook(void);

/** \brief Task Declaration of Task InitTask */
DeclareTask(InitTask);
/** \brief Task Declaration of Task PeriodicTask */
DeclareTask(LcdTask);
DeclareTask(MatrizTask);
DeclareTask(RegistrosTask);
DeclareTask(SwitchesTask);



/** \brief Schedule this Task if higher priority Task are Active
 **
 ** This API shall Schedule the calling Task if a higher priority Task
 ** is active. This API shall only be used from non preemtive tasks.
 **
 ** \remarks This interface may be used by the end user over the
 **          macro Schedule or from the system itself. Therefore
 **          the parameter PerformChecks is provided. When
 **          the user calls the scheduler the checks shall be
 **          performed if the error checking is set as extended.
 **          If the system calls the Schedule no error checking
 **          shall be performed, the system shall be trusted.
 **
 ** \param[in] PerformChecks indicates if the function shall or not
 **                          perform the extended checks. This parameter
 **                          is only available if the error checks are set
 **                          to extended.
 ** \return E_OK if no error
 ** \return E_OS_CALLEVEL if call at interrupt level
 ** \return E_OS_RESOURCE if the calling task occupies resources
 **/
extern StatusType Schedule_Int(boolean PerformChecks);

/** @} doxygen end group definition */
/** @} doxygen end group definition */
/** @} doxygen end group definition */
/*==================[end of file]============================================*/
#endif /* #ifndef _OS_CFG_H_ */
