csraxll/taller1-g8/Software/Firmware/proyecto/inc/lcd.h

/*
 * lcd.h
 *
 *  Created on: 30/07/2013
 *      Author: pc2
 */

#ifndef LCD_H_
#define LCD_H_

#endif /* LCD_H_ */

#define LCD_SEC_LINE    0x40    // Address of the second line of the LCD

// LCD configuration constants
#define CURSOR_ON       2
#define CURSOR_OFF      0
#define CURSOR_BLINK    1
#define CURSOR_NOBLINK  0
#define DISPLAY_ON      4
#define DISPLAY_OFF     0
#define DISPLAY_8X5     0
#define DISPLAY_10X5    4
#define _2_LINES        8
#define _1_LINE         0


//**************************************************************************
//* Prototypes
//**************************************************************************
void LCD_init(char mode1, char mode2);
void LCD_update (void);
void LCD_escribir_flecha_adelante (void);
void LCD_escribir_flecha_atras (void);
void LCD_pos_xy(char x, char y);
void LCD_clear_buffer (void);
void LCD_write_string_to_buffer (const char* STR_PTR);
void LCD_write_char_to_buffer (const char Data);
void LCD_display_on(void);
void LCD_display_off(void);
void LCD_cursor_on(void);
void LCD_cursor_off(void);
void LCD_cursor_blink_on(void);
void LCD_cursor_blink_off(void);
uint8_t LCD_end_writing(void);
