csraxll/taller1-g8/Software/Firmware/proyecto/inc/registros.h

/*
 * registros.h
 *
 *  Created on: 31/10/2015
 *      Author: zorito1994
 */

#ifndef PROYECTO_INC_REGISTROS_H_
#define PROYECTO_INC_REGISTROS_H_





#endif /* PROYECTO_INC_REGISTROS_H_ */

#include "interfaz.h"

void Registros_EscribirMatriz (uint8_t matriz[NUM_FILAS][NUM_COLUMNAS]);
void Registros_ActivarColumna (void);
