csraxll/taller1-g8/Software/Firmware/proyecto/inc/switches.h

/*
 * switches.h
 *
 *  Created on: 28/10/2015
 *      Author: zorito1994
 */

#ifndef PROYECTO_INC_SWITCHES_H_
#define PROYECTO_INC_SWITCHES_H_



#endif /* PROYECTO_INC_SWITCHES_H_ */

void Switches_MenuPrincipal (void);

void Switches_Inicializar (void);

void Switches_Polling (void);

uint8_t Switches_GetEstado (void);
