csraxll/taller1-g8/(commit log)

2015-09-29 Esquemático de la CIAA, el poncho y la matriz de LEDs
2015-10-29 Cambios en los esquematicos y nueva estructura de los directorios
    [poncho.sch, taller1-g8.kicad_pcb, taller1-g8.sch]
2015-11-12 Programa escrito en C para controlar la matriz de LEDs
    [ciaa-fsl.cfg, ciaa-nxp.cfg, ciaa.cfg, ciaaconfig.cfg, ctestcases.cfg, testcases.cfg]
2015-11-23 Actualizacion de diseño en PCB utilizando Template del repositorio Ponchos
    [ControladorMatrizLED.kicad_pcb, ControladorMatrizLED.sch, Esquematico_CMLED.sch, poncho.sch, taller1-g8.kicad_pcb, taller1-g8.sch]
2015-11-26 Avance sobre Esquematico y PCB - Pistas terminadas
    [ControladorMatrizLED.kicad_pcb, ControladorMatrizLED.sch, Esquematico_CMLED.sch]
2015-11-29 Pistas completas y prueba de impreso añadida
    [ControladorMatrizLED.kicad_pcb, ControladorMatrizLED.sch]
2015-12-13 Actualizacion con modelo poncho grande y LCD
    [ControladorMatrizLED.kicad_pcb, ControladorMatrizLED.sch, Esquematico_CMLED.sch, conector_poncho.sch]
2016-01-29 Agregados archivos de PCB para la Matriz de LEDs como un añadido al poncho
    [MatrizLED.kicad_pcb, MatrizLED.sch]
2016-01-29 Actualizada placa de matrices
    [MatrizLED.kicad_pcb, MatrizLED.sch]
2016-02-18 Diseño esquemático y PCB del controlador y del cartel LED
    [ciaa-fsl.cfg, ciaa-nxp.cfg, ciaa.cfg, ciaaconfig.cfg, ctestcases.cfg, testcases.cfg]
2016-02-18 Programa escrito en C para proveer las funcionalidades del sistema
    [ciaa-fsl.cfg, ciaa-nxp.cfg, ciaa.cfg, ciaaconfig.cfg, ctestcases.cfg, testcases.cfg]
2016-02-21 Actualizada informacion en doc de archivos de Hardware
2016-02-22 Agregadas hojas de datos de componentes utilizados
    [MatrizLED.sch]
